SachinSalaskar12/Two-Piece-Electronic-Enclosure/media/drawing_sheets.png

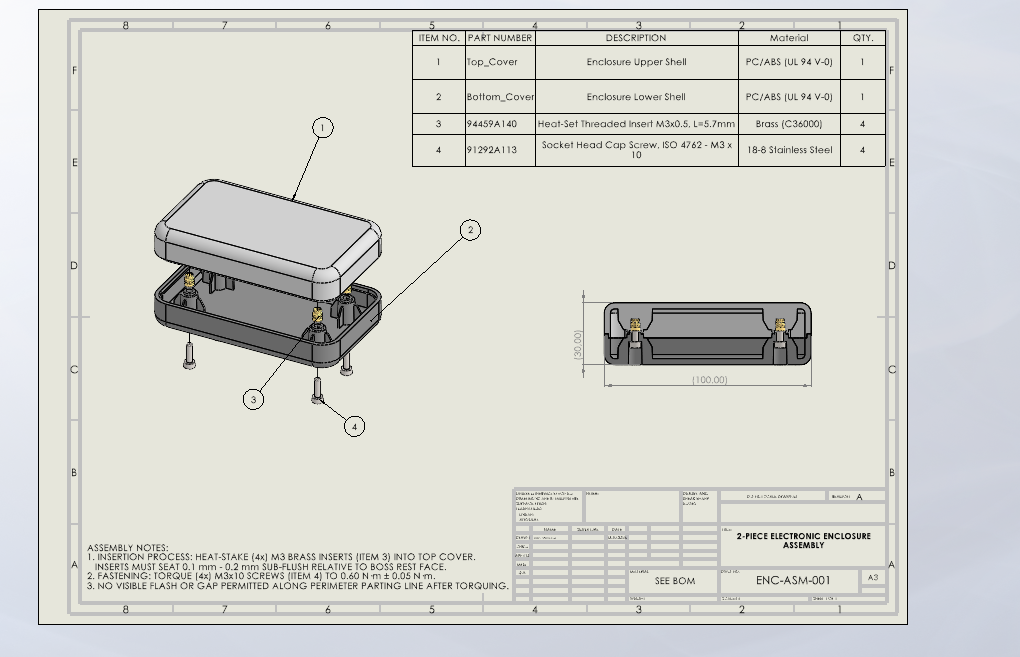
media/drawing_sheets.png
