SachinSalaskar12/Two-Piece-Electronic-Enclosure/cad/neutral/Enclosure_Assembly.step

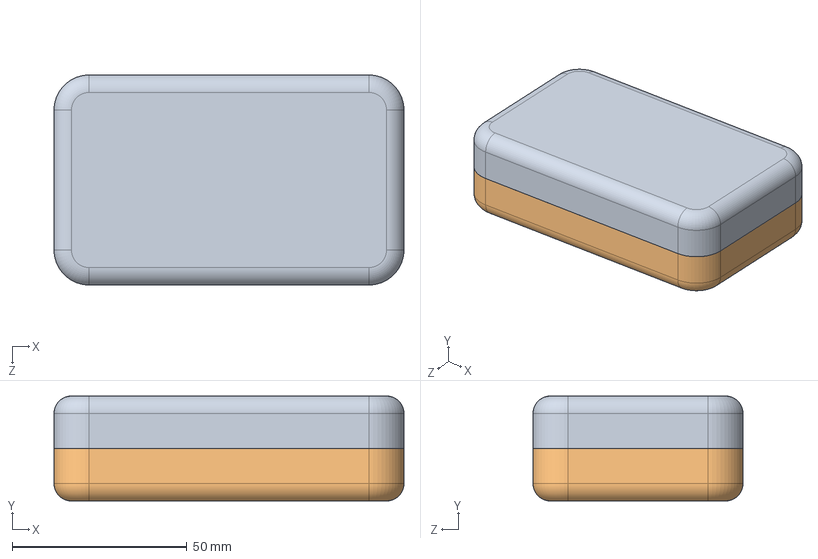
[picture p4: CAD file, 2026-10-14]
cad/neutral/Enclosure_Assembly.step
100.0 x 30.0 x 60.0 mm
Top_Cover
Bottom_Cover
94459A140_Heat-Set Inserts for Plastic_94459A140 x 4
91292A113_18-8 Stainless Steel Socket Head Screw_91292A113 x 4
