SachinSalaskar12/Two-Piece-Electronic-Enclosure/cad/neutral/Bottom_Cover.STEP

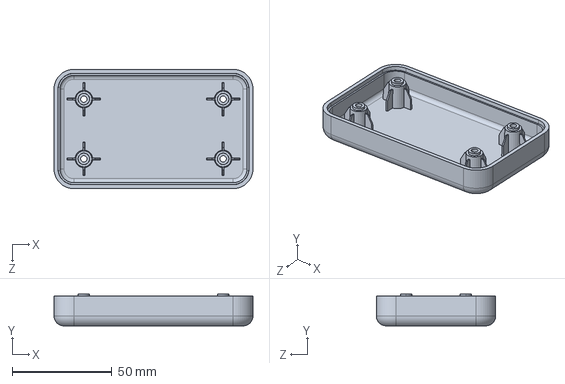
[picture p5: CAD file, 2026-10-14]
cad/neutral/Bottom_Cover.STEP
100.0 x 15.9 x 60.0 mm
