SachinSalaskar12/Two-Piece-Electronic-Enclosure/cad/neutral/Top_Cover.STEP

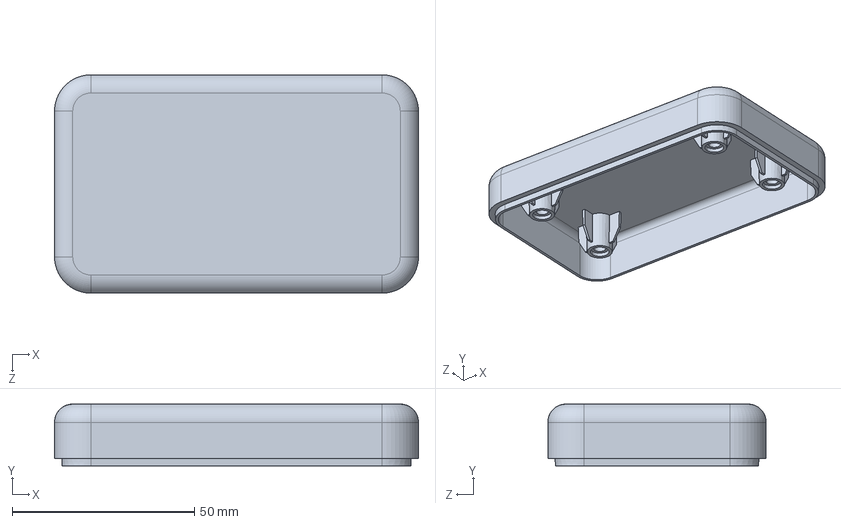
[picture p6: CAD file, 2026-10-14]
cad/neutral/Top_Cover.STEP
100.0 x 17.0 x 60.0 mm
