SachinSalaskar12/Two-Piece-Electronic-Enclosure/cad/solidworks/Coverpart.SLDPRT

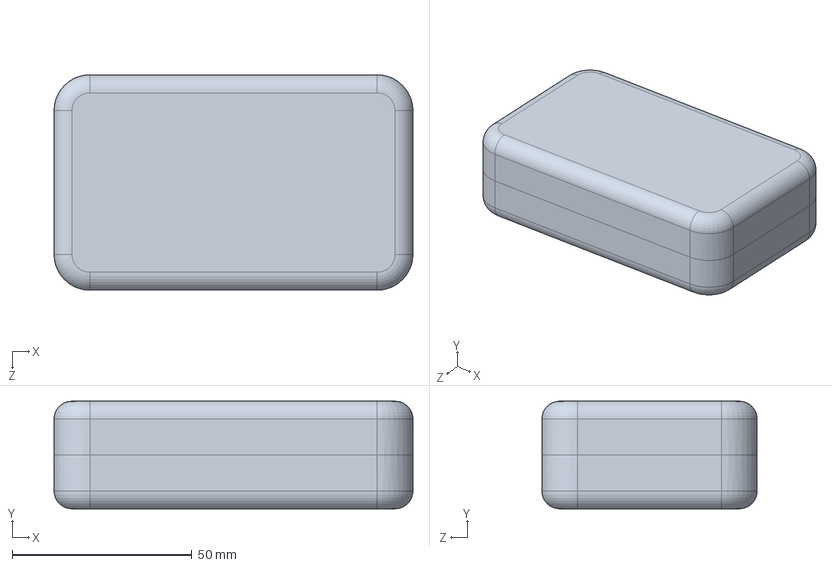
[picture p7: CAD file, 2026-10-14]
cad/solidworks/Coverpart.SLDPRT
100.0 x 30.0 x 60.0 mm
