SachinSalaskar12/Two-Piece-Electronic-Enclosure/cad/solidworks/BoxEnclosureAsm.SLDASM

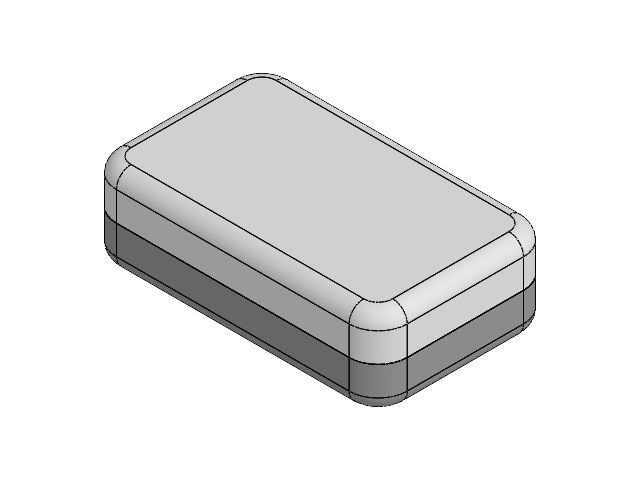
[picture p8: CAD file, 2026-10-14]
cad/solidworks/BoxEnclosureAsm.SLDASM
Top_Cover
Bottom_Cover
94459A140_Heat-Set Inserts for Plastic x 4
91292A113_18-8 Stainless Steel Socket Head Screw x 4
