SachinSalaskar12/Two-Piece-Electronic-Enclosure/(list of files, cad)

Other CAD files:
cad/solidworks/Bottom_Cover.SLDPRT
cad/solidworks/Top_Cover.SLDPRT
