SachinSalaskar12/Two-Piece-Electronic-Enclosure/drawings/ENC-ASM-001_Assembly_BOM.PDF

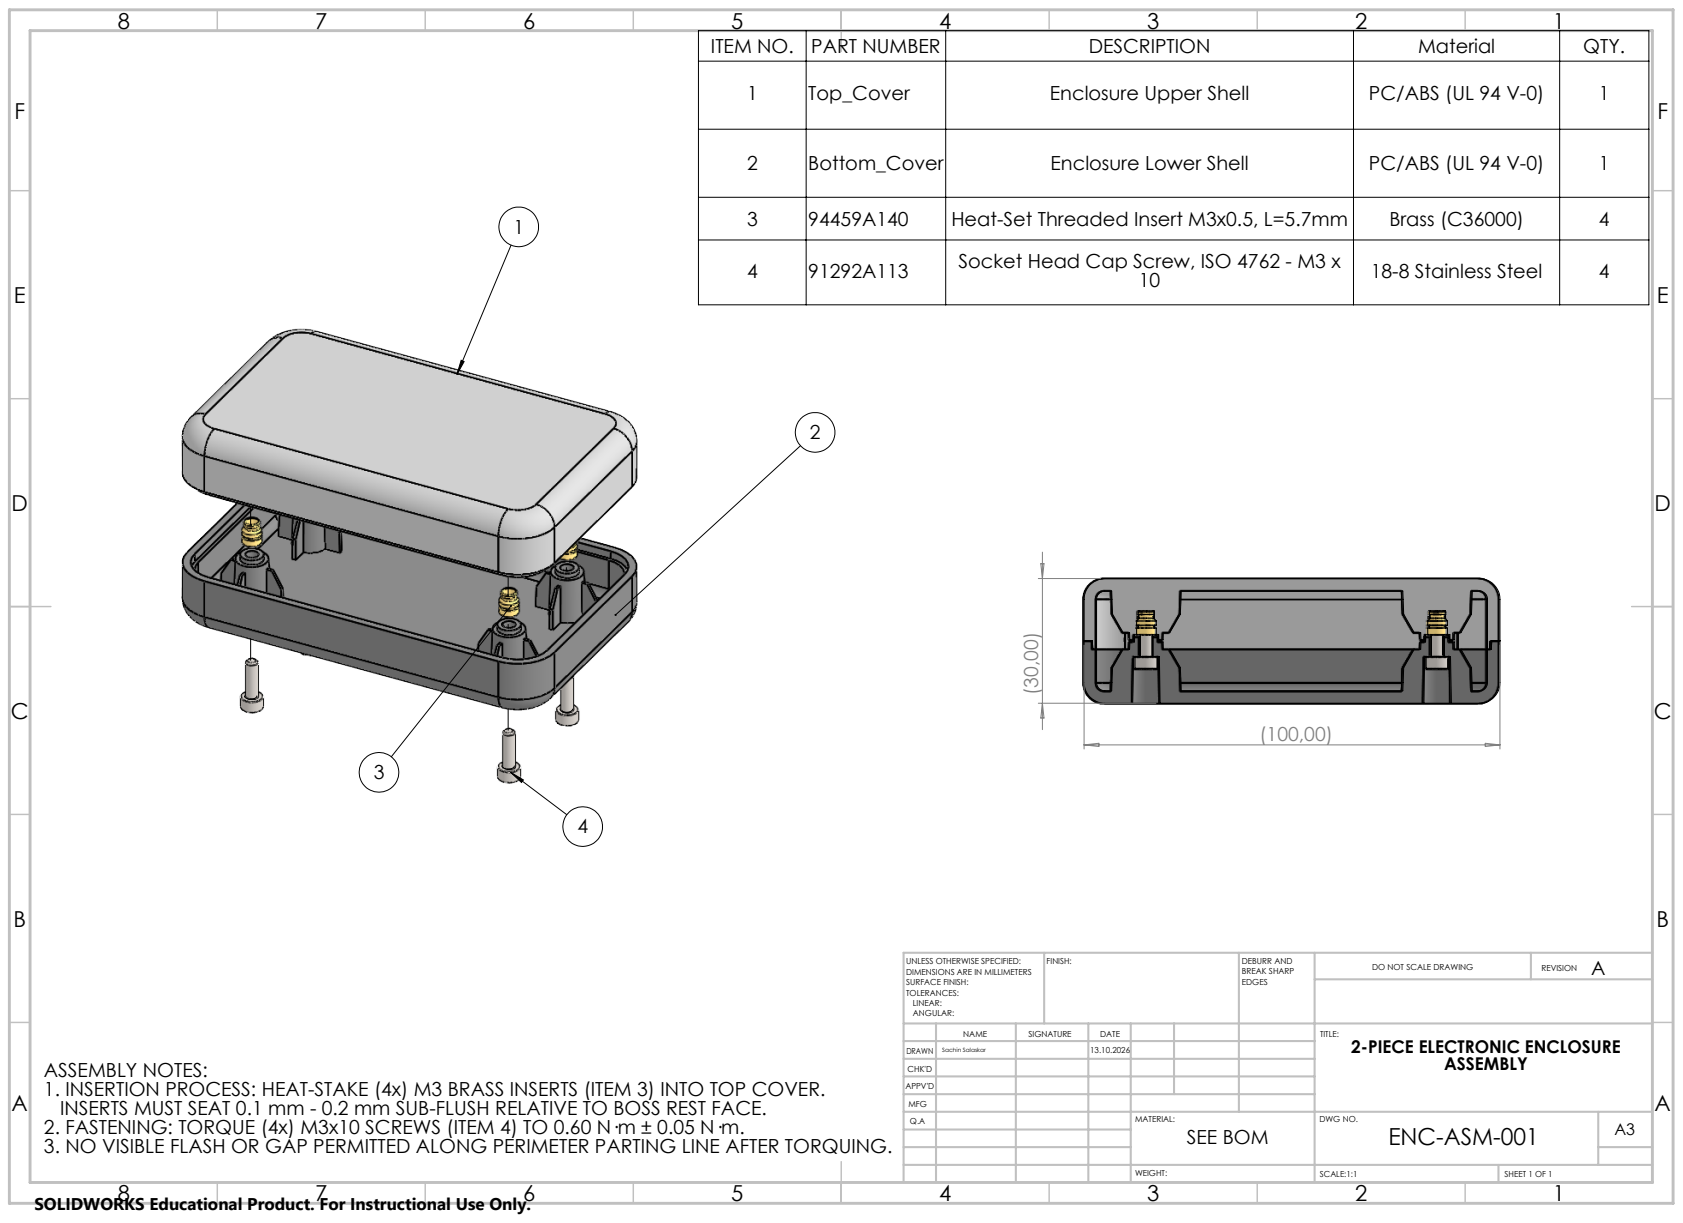
[picture p9: page 1]
FINISH:; DEBURR AND; BREAK SHARP; DO NOT SCALE DRAWING; REVISION; SCALE:1:1; SHEET 1 OF 1

ITEM NO. | PART NUMBER | | DESCRIPTION | Material | QTY.
1 | Top_Cover | | Enclosure Upper Shell | PC/ABS (UL 94 V-0) | 1

2 | Bottom_Cover | | Enclosure Lower Shell | PC/ABS (UL 94 V-0) | 1

3 | 94459A140 | | Heat-Set Threaded Insert M3x0.5, L=5.7mm | Brass (C36000) | 4
4 | 91292A113 | | Socket Head Cap Screw, ISO 4762 - M3 x 10 | 18-8 Stainless Steel | 4

UNLESS OTHERWISE SPECIFIED:
DIMENSIONS ARE IN MILLIMETERS
SURFACE FINISH:
TOLERANCES:
LINEAR:
ANGULAR:

NAME | SIGNATURE | DATE | | | | TITLE: 2-PIECE ELECTRONIC ENCLOSURE ASSEMBLY

DRAWN | Sachin Salaskar | | 13.10.2026
CHK'D
APPV'D
MFG
Q.A | | | | MATERIAL: SEE BOM | DWG NO. ENC-ASM-001 | A3

ASSEMBLY NOTES:
1. INSERTION PROCESS: HEAT-STAKE (4x) M3 BRASS INSERTS (ITEM 3) INTO TOP COVER.
INSERTS MUST SEAT 0.1 mm - 0.2 mm SUB-FLUSH RELATIVE TO BOSS REST FACE.
2. FASTENING: TORQUE (4x) M3x10 SCREWS (ITEM 4) TO 0.60 N·m ± 0.05 N·m.
3. NO VISIBLE FLASH OR GAP PERMITTED ALONG PERIMETER PARTING LINE AFTER TORQUING.
SOLIDWORKS Educational Product. For Instructional Use Only.
