SachinSalaskar12/Two-Piece-Electronic-Enclosure/hardware/McMaster_91292A113_Screw.pdf

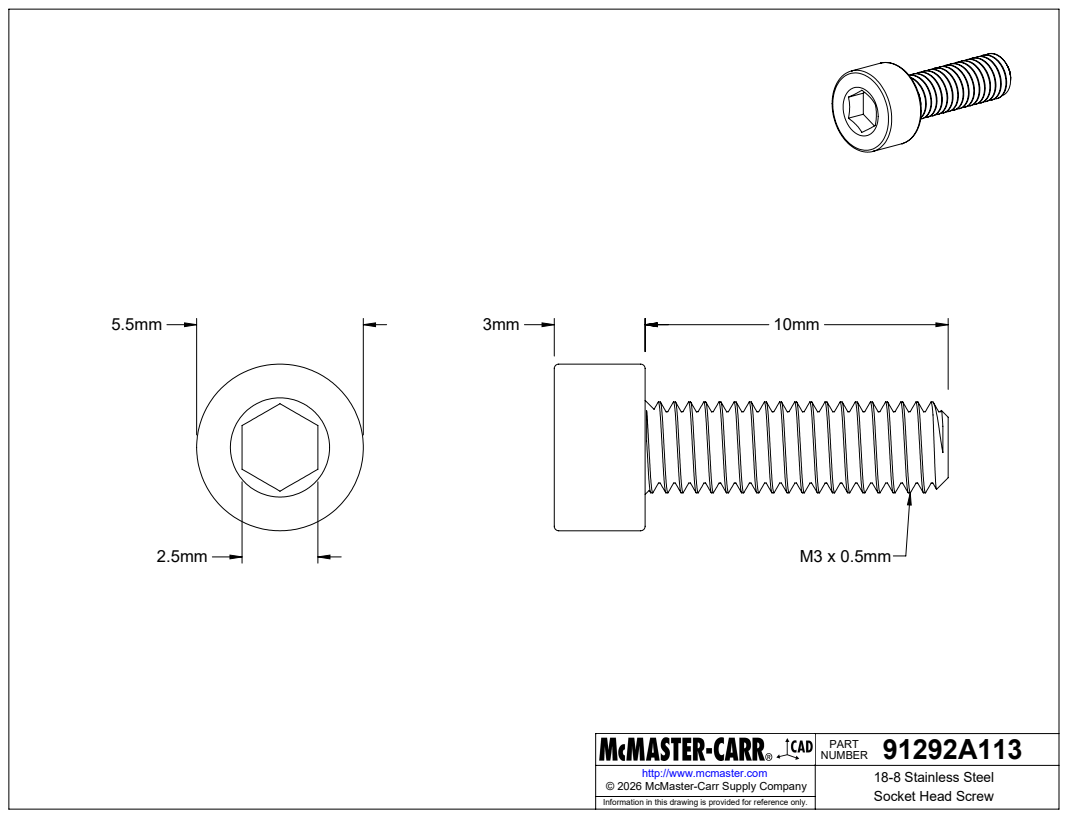
[picture p10: page 1]

91292A113 PART NUMBER

http://www.mcmaster.com | 18-8 Stainless Steel Socket Head Screw © 2026 McMaster-Carr Supply Company

Information in this drawing is provided for reference only.
