SachinSalaskar12/Two-Piece-Electronic-Enclosure/hardware/McMaster_94459A140_Insert.pdf

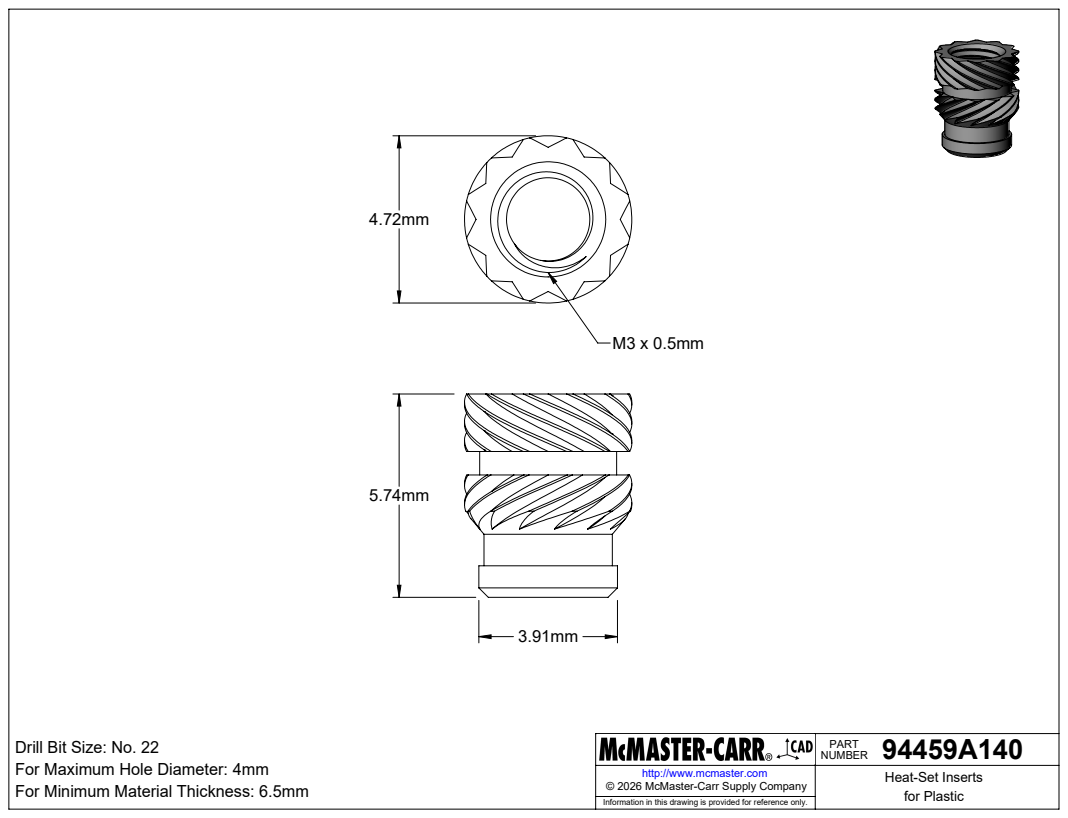
[picture p11: page 1]
For Minimum Material Thickness: 6.5mm; for Plastic © 2026 McMaster-Carr Supply Company

94459A140 PART NUMBER

Drill Bit Size: No. 22
For Maximum Hole Diameter: 4mm

http://www.mcmaster.com | Heat-Set Inserts

Information in this drawing is provided for reference only.
