SachinSalaskar12/Two-Piece-Electronic-Enclosure/drawings/Bottom_Cover_Production_Drawing.PDF

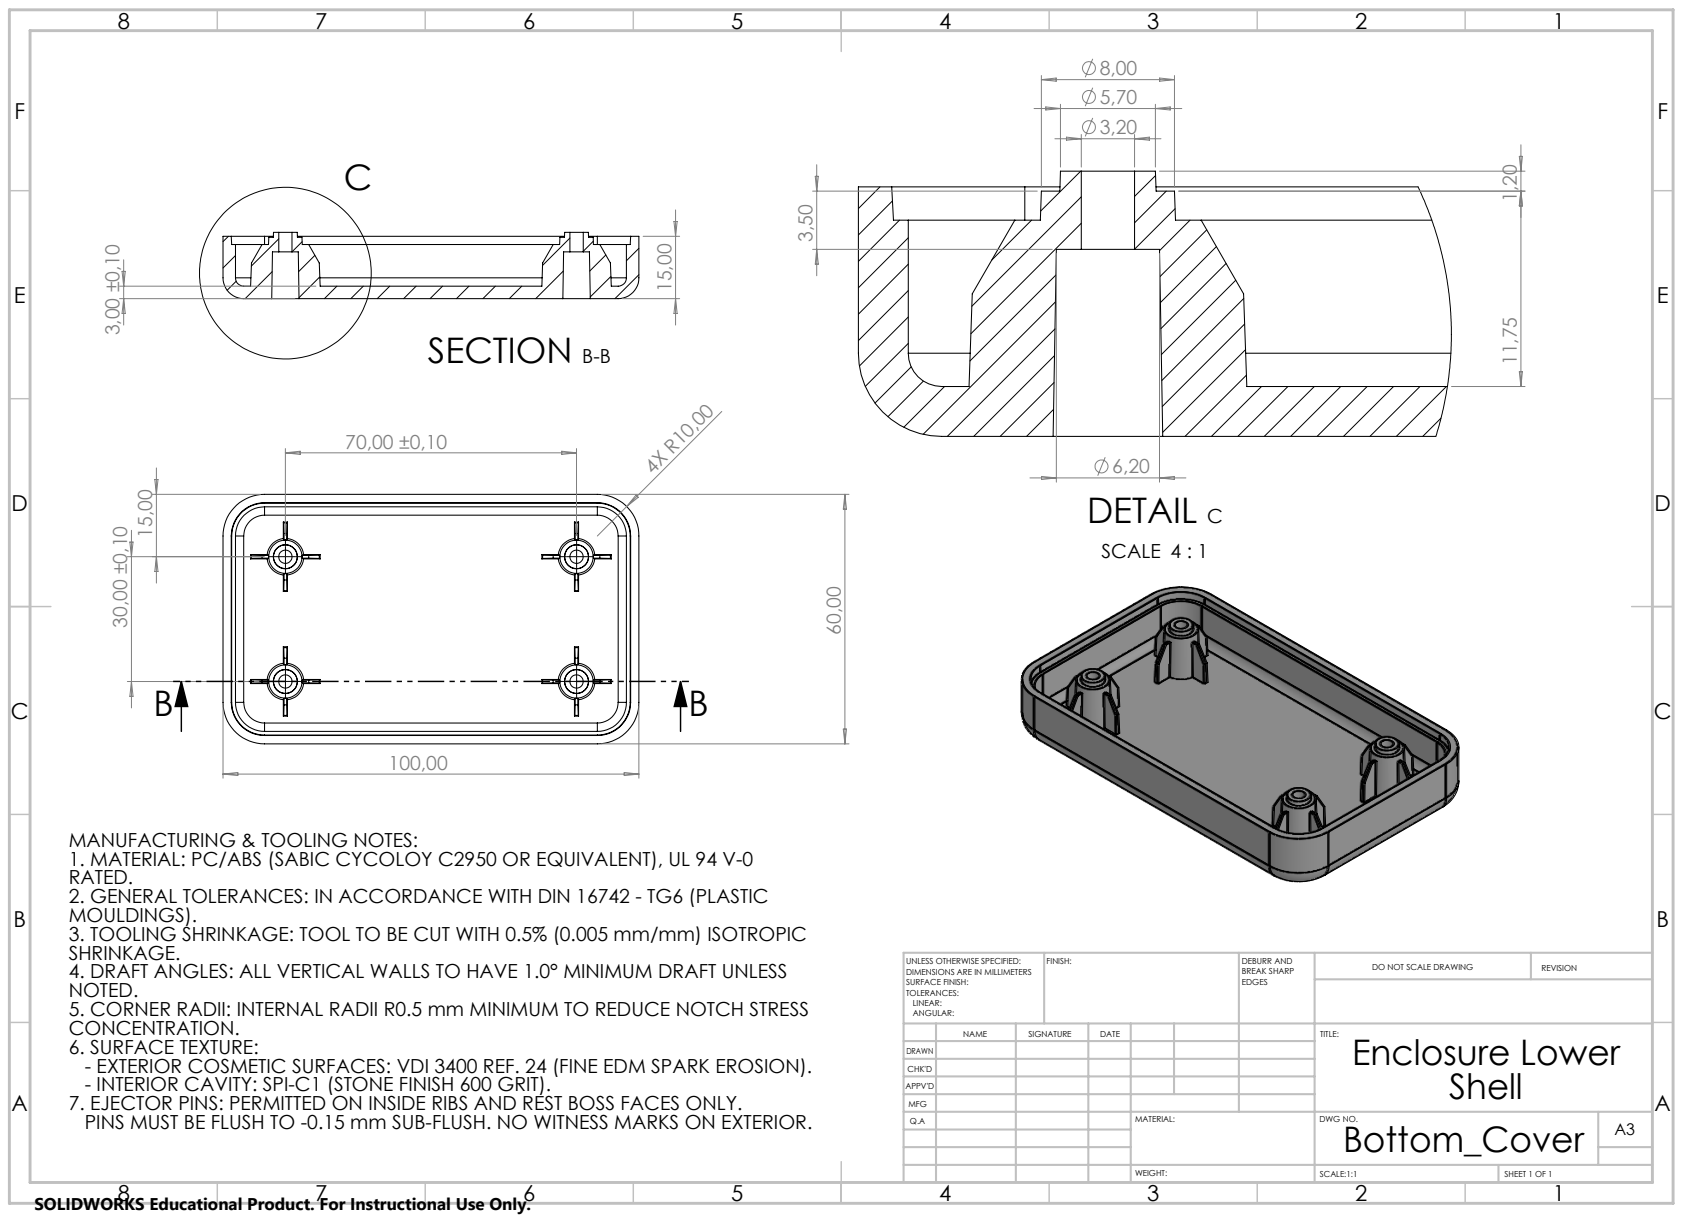
[picture p12: page 1]
SECTION B-B; DETAIL C; SCALE 4 : 1; FINISH:; DEBURR AND; BREAK SHARP; DO NOT SCALE DRAWING; REVISION; SCALE:1:1; SHEET 1 OF 1

MANUFACTURING & TOOLING NOTES:
1. MATERIAL: PC/ABS (SABIC CYCOLOY C2950 OR EQUIVALENT), UL 94 V-0
RATED.
2. GENERAL TOLERANCES: IN ACCORDANCE WITH DIN 16742 - TG6 (PLASTIC
MOULDINGS).
3. TOOLING SHRINKAGE: TOOL TO BE CUT WITH 0.5% (0.005 mm/mm) ISOTROPIC
SHRINKAGE.
4. DRAFT ANGLES: ALL VERTICAL WALLS TO HAVE 1.0° MINIMUM DRAFT UNLESS
NOTED.
5. CORNER RADII: INTERNAL RADII R0.5 mm MINIMUM TO REDUCE NOTCH STRESS
CONCENTRATION.
6. SURFACE TEXTURE:
- EXTERIOR COSMETIC SURFACES: VDI 3400 REF. 24 (FINE EDM SPARK EROSION).
- INTERIOR CAVITY: SPI-C1 (STONE FINISH 600 GRIT).
7. EJECTOR PINS: PERMITTED ON INSIDE RIBS AND REST BOSS FACES ONLY.
PINS MUST BE FLUSH TO -0.15 mm SUB-FLUSH. NO WITNESS MARKS ON EXTERIOR.

UNLESS OTHERWISE SPECIFIED:
DIMENSIONS ARE IN MILLIMETERS
SURFACE FINISH:
TOLERANCES:
LINEAR:
ANGULAR:

NAME | SIGNATURE | DATE | | | | TITLE: Enclosure Lower Shell

DRAWN
CHK'D
APPV'D
MFG
Q.A | | | | MATERIAL: | DWG NO. Bottom_Cover | A3

SOLIDWORKS Educational Product. For Instructional Use Only.
